surajswaminathan05-png/Spine-Savior/enclosure-box/images/Screen_Shot_2022-02-14_at_22.57.49.png

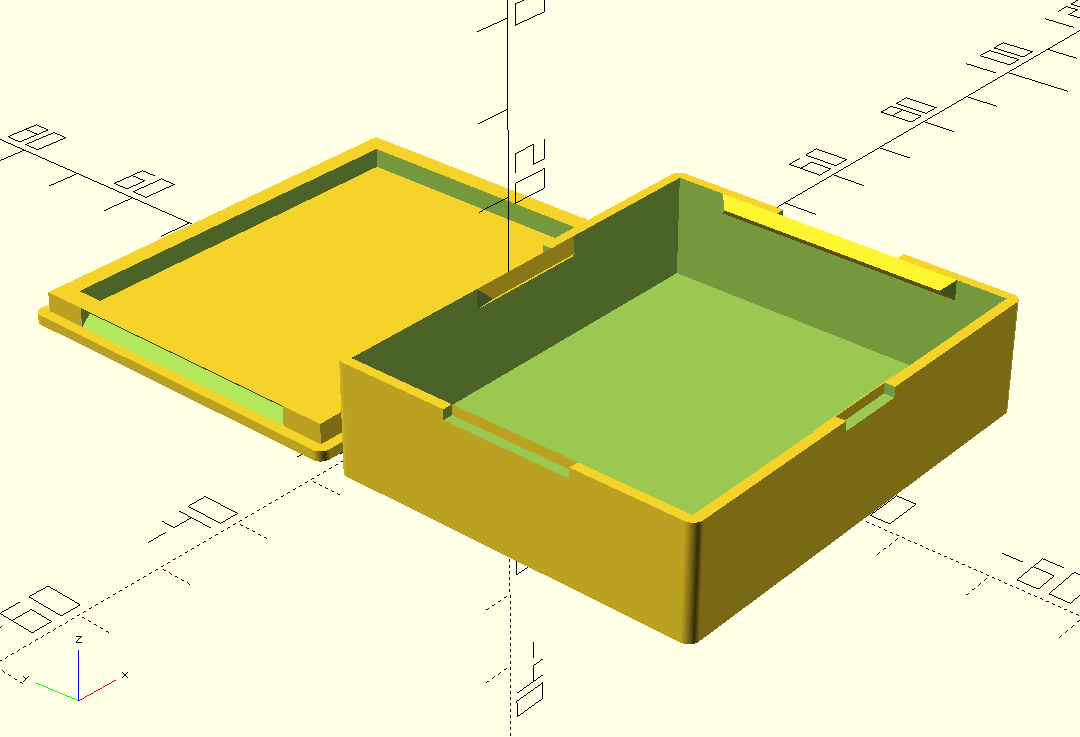
enclosure-box/images/Screen_Shot_2022-02-14_at_22.57.49.png
