surajswaminathan05-png/Spine-Savior/enclosures/sensor_2x1.5in.stl

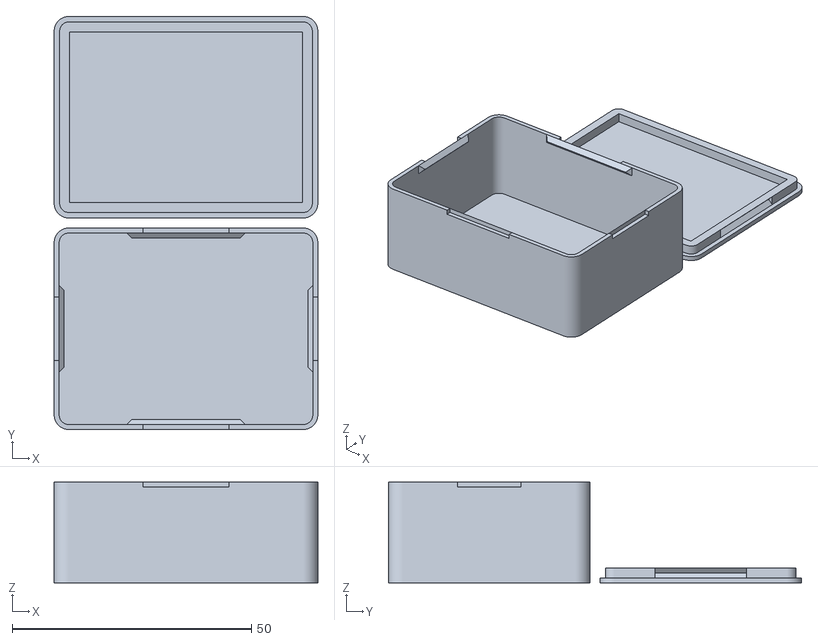
[picture p10: CAD file, 2026-03-07]
enclosures/sensor_2x1.5in.stl
55.1 x 86.3 x 21.1
