surajswaminathan05-png/Spine-Savior/enclosures-v2/sensor_2x1.5in.stl

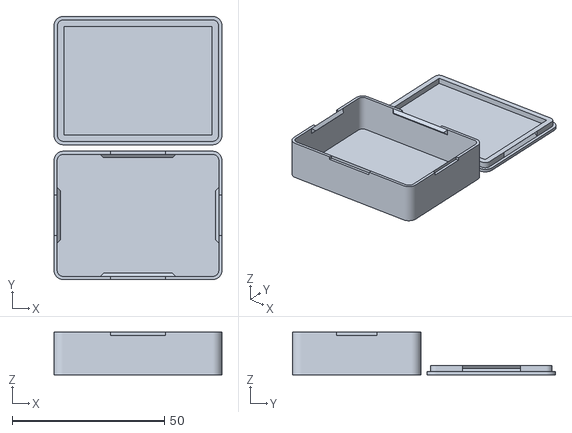
[picture p11: CAD file, 2026-03-07]
enclosures-v2/sensor_2x1.5in.stl
55.1 x 86.3 x 14.1
