surajswaminathan05-png/Spine-Savior/enclosures/sensor_1.4x1.5in.stl

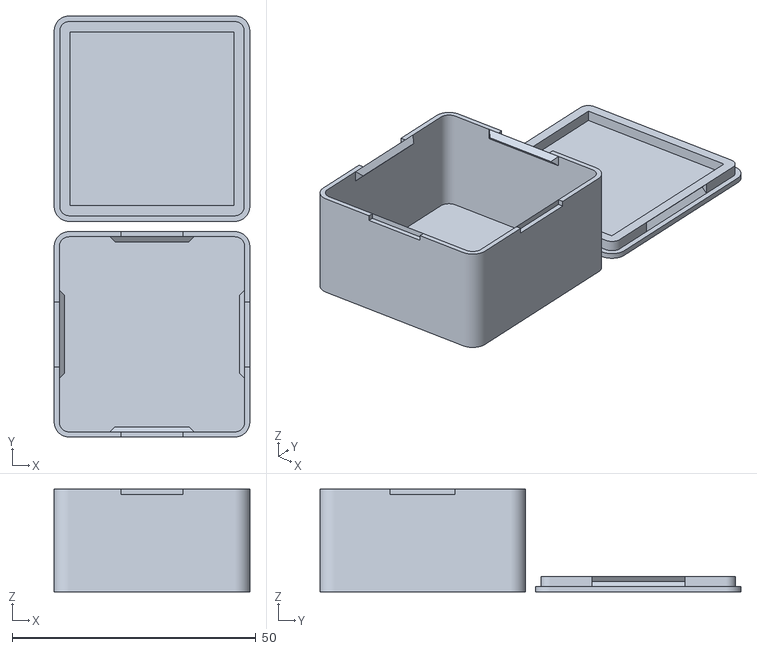
[picture p12: CAD file, 2026-03-07]
enclosures/sensor_1.4x1.5in.stl
40.1 x 86.3 x 21.1
