surajswaminathan05-png/Spine-Savior/enclosures-v2/central_hub_3.5x2in.stl

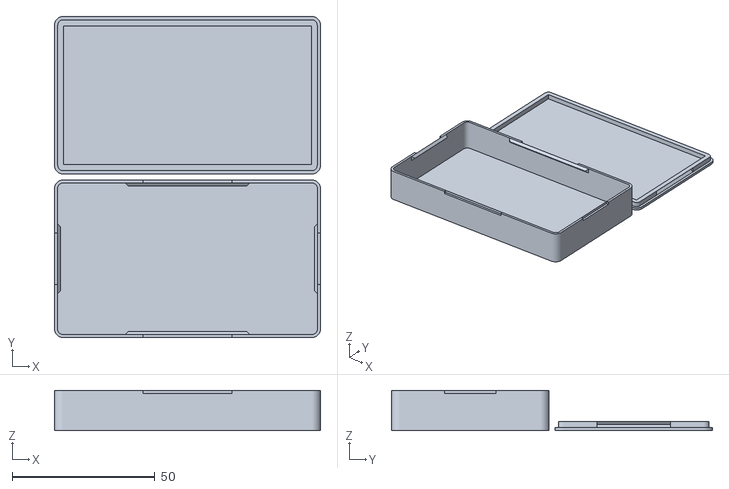
[picture p13: CAD file, 2026-03-07]
enclosures-v2/central_hub_3.5x2in.stl
93.1 x 112.3 x 14.1
