surajswaminathan05-png/Spine-Savior/enclosures/central_hub_3.5x2in.stl

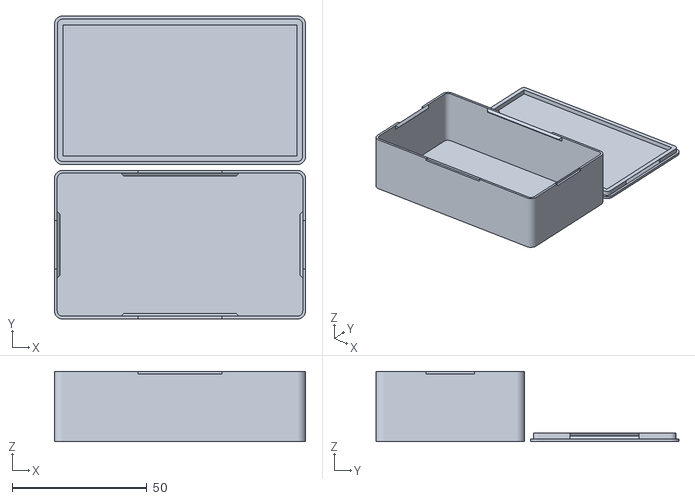
[picture p14: CAD file, 2026-03-07]
enclosures/central_hub_3.5x2in.stl
93.1 x 112.3 x 26.1
