surajswaminathan05-png/Spine-Savior/(list of files, cad)

Other CAD files:
enclosures-v2/sensor_2x1.5in.scad
enclosures/sensor_1.4x1.5in.scad
enclosures/sensor_2x1.5in.scad
enclosures-v2/central_hub_3.5x2in.scad
enclosures/central_hub_3.5x2in.scad
enclosure-box/files/enclosure_snap.scad
