surajswaminathan05-png/Spine-Savior/(commit log)

2026-03-06 fix: remap sensor-to-region assignment to match hardware wiring
    Port 0 now maps to thoracic, port 2 to lumbar, and port 3 to cervical, matching the physical Adafruit sensor placement on the soldered hardware.
2026-03-07 Stable version v1 - complete working state with posture ML, enclosures, and UI updates
    [central_hub_3.5x2in.scad, central_hub_3.5x2in.stl, enclosure_snap.scad, sensor_1.4x1.5in.scad, sensor_1.4x1.5in.stl, sensor_2x1.5in.scad, sensor_2x1.5in.stl]
2026-03-08 Bluetooth v1 - BLE integration with SpineSaviorBLE Arduino sketch
2026-03-09 haptic-motor-v1: Add haptic feedback system with vibration motor control
    [SpineSaviorBLE.ino]
2026-03-12 Haptic Motor Working v1 - verified haptic feedback implementation
2026-03-12 fix: haptic motor - correct pin (D5) + reliable timer-based trigger
2026-03-12 Kinematic chain v1: quaternion-based forward kinematics, updated firmware and posture ML
2026-03-13 Kinematic Chain v2: fix camera follow snap-back, auto-calibrate in simulation mode, dual-mode BLE parsing, spineRoot global tilt, SLERP smoothing, inter-segmental posture scoring
